cairuijie-cai/RC-volleyball/2027/素材/31x31x19角码参考工程图/尺寸依据与待确认项.md

# 31×31×19角码尺寸参考图

依据用户提供的商品尺寸图与聊天截图整理，不是厂家原始工程图。

商品图标注外包络31×31×19 mm、厚度2 mm、孔径6 mm，以及竖直面8/12/9 mm尺寸链。商家称两孔横向错位约5 mm，没有确认准确的侧边距。

## 图中的假设

- 横向孔中心暂按7 mm、12 mm示意，等于在19 mm宽度中对称偏置±2.5 mm；准确坐标未知。
- 竖直面孔心由上边向下8 mm、再向下12 mm推算，得到从外包络底边向上23 mm、11 mm。
- 9 mm的基准暂理解为底板内表面；8+12+9=29 mm，加厚度2 mm得到31 mm。这不是实物测量。
- 底面孔心沿腿长暂参照竖直面，准确纵向距离及横向错位方向均需实测。
- 外圆角、内折弯半径、孔口是否沉孔/沉头/翻边、材质、表面处理、公差没有资料，因此未补造。
- 侧视折弯处采用直角轮廓示意，不提供展开图或下料尺寸。

PDF/SVG用于尺寸沟通和装配参考。DXF几何按毫米1:1建立，布局为独立参考视图，并以原生DIMENSION实体记录基本尺寸；没有用AutoCAD或SolidWorks原生打开验收，不是SLDDRW/DWG。

核对实物时至少测量两面的每个孔心到同一侧边、自由端边的距离，以及内折弯R和孔口形状。配套零件的匹配孔位应以该实测值为准。
