cairuijie-cai/RC-volleyball/2027/素材/宇树M8010/官方文档/STM32例程_官方原文.md

# GO-M8010-6 关节电机 STM32 HAL 通讯例程

[GoM_ComDemo_STM32_HAL.zip](https://oss-global-cdn.unitree.com/static/7af2438fd70548879b80a0068ef159b3.zip)

基于 STM32F103C8T6 的 GO-M8010-6 关节电机通讯协议 Demo。如果要移植到其他型号的 MCU，推荐使用带有 FPU 的 MCU。

## 硬件要求

1. **MCU UART/USART 外设**需要支持 4Mbps 的波特率。
2. [TTL转RS485模块](https://detail.tmall.com/item.htm?id=679335252560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)（RS485 收发器）需要支持 4Mbps 的波特率（Unitree 旗舰店有售）。

## TTL 转 RS485 模块的连线

| [TTL 转 485 模块] | [MCU]  |
|---|---|
| RX | PA10 |
| TX | PA9 |
| RE/DE | PA11 |
| 5V | 5V |
| GND | GND |



## RS485 线序定义

[RS485 线序定义](https://support.unitree.com/home/zh/Motor_SDK_Dev_Guide/4-channel_485_to_USB_module)

推荐使用 GH1.25-3P 连接器，可以搭配 Unitree 电机附件包使用。为了保证可靠的通讯质量，RS485 总线的 GND 与 MCU 的 GND 必须连接到一起。

## 注意事项

- 请勿将 RS485 的 A 或 B 连通高压，例如 A 与 DC24v 连通。这会造成总线上的所有非隔离的 RS485 设备烧毁，并且这不在保修范围内。

## 调试流程

将``TTL转485模块``引出的``RS485信号线``与电机连接。
将SWD接口与调试器连接，开发板供电。

下载例程程序后，进入Debug模式调试。

添加`Watch 1`窗口

添加 `cmd` 和 `data`变量

点击Run按钮 开始执行程序

此时查看`Watch 1`窗口，展开`data`变量，可以看到数据开始更新，`timeout`应为0，这是正常的。

如果没有与电机成功建立连接，则`timeout`会一直增加

查看`Watch 1`窗口，展开`cmd`变量，将`mode`设置为5，电机会开始缓慢开环转动
此时 T/W/Pos/K_P/K_W 参数不会响应
`mode`设置为0，电机停止转动

将`mode`设置为1，T/W/Pos/K_P/K_W均设置为0，电机进入零力矩模式，用手转动输出端会发现阻力很小，类似于电机没有上电时的状态。

T/W/Pos/K_P/K_W的参数设置请参考：[https://support.unitree.com/home/zh/Motor_SDK_Dev_Guide/overview](https://support.unitree.com/home/zh/Motor_SDK_Dev_Guide/overview)

> 请注意，使用该例程控制电机所有的参数均为转子侧（而不是输出端侧）

STM32的例程与C++版本的例程，参数命名并不相同，请您留意：
| col | [stm32] | [C++] |
| - | - | - |
| 前馈力矩 | T | Tau |
| 期望角度位置 | Pos | Q_des |
| 期望角速度 | W | dq_des |
| 期望刚度  | K_P | Kp |
| 期望阻尼  | K_W | Kd |
