cairuijie-cai/RC-volleyball/2027/素材/宇树M8010/官方文档/关于M8010_官方原文.md

# 关于 GO-M8010-6 电机

<center>



</center>

**GO-M8010-6** 是宇树推出的一款一体化关节电机模组，内部集成了**无刷电机**、**减速器**、**单圈绝对值编码器**与 **FOC 驱动板**。用户可通过高速 RS485 通信下发位置、速度、力矩及力位混合控制指令，适用于四足机器人、机械臂、移动机器人关节、教学科研与竞赛开发等场景。

## 电机参数

| 参数类型 | 参数 | 参数类型 | 参数 |
| :---: | :---: | :---: | :---: |
| 通信方式 | RS485 | 波特率 | 4.0 Mbit/s |
| 数据位 | 8 | 校验位 | None |
| 停止位 | 1 | 串口格式 | 8N1 |
| 工作电压 | 12V ~ 30V DC，推荐 24V DC | 演示例程最低供电能力  | 24V / 5A |
| 最大绝对耐压 | 60V | 过压保护电压 | 45V |
| 最大相电流 | 40A | 建议线缆 |  ≥18AWG，线长 <1m |
| 电机 ID | 0~14 | 单总线电机数量 | 最多 15 个 |
| 控制帧长度 | 17 Byte | 反馈帧长度 | 16 Byte |
| 校验方式 | CRC16_CCITT | 减速比 | 1:6.33 |
| 最大扭矩 | 23.7 N·m | 扭矩常数 | 0.63895 N·m/A |
| 最大转速 | 30 rad/s（24V 供电时） | 电机重量 | 约 530g |
| 电机尺寸 | 96.5 × 92.5 × 42.3 mm | 编码器分辨率 | 15 bit |
| 通信控制频率 | 6000 Hz | 使用环境 | -5℃ ~ 40℃ |
| 电机感知反馈 | 力矩、角度、角速度、温度 | 电机控制指令 | 力矩、角度、角速度、刚度、阻尼 |

## 控制模型

GO-M8010-6 支持力位混合控制，核心关系为：

$$
\tau = \underbrace{\tau_{ff}}_{\text{前馈力矩}} + \underbrace{k_p(q_{des}-q)}_{\text{位置误差力矩}} + \underbrace{k_d(\dot{q}_{des}-\dot{q})}_{\text{速度误差力矩}}
$$

> **注意**
> 
> - SDK 和协议中的控制量默认按**电机转子侧**理解，不是输出端侧。
> - 输出端位置、速度换算到转子侧时，需要乘以 GO-M8010-6 的减速比 **6.33**。

## 电机参数曲线

<center>



</center>

说明：上图为 GO-M8010-6 的 TN 曲线，数据为**转子侧**在 **24V 供电**下测得，用于查看不同转速下的扭矩能力。

## 供电说明

> **警告：制动 / 正反转快速切换工况下存在母线过压风险**

> **注意**
> 
> - 满足演示例程至少需要 **24V、5A** 的供电能力。
> - 线缆建议至少 **18AWG**，线长 **< 1m**。
> - 实际供电能力需按负载、加速度和同时动作电机数量留裕量。

### 制动工况下的母线过压风险

电机在正反转快速切换、位置阶跃响应或急减速制动过程中，转子动能会转化为电能回馈至直流母线。若供电电源为普通开关电源，且不具备能量吸收能力，该电能无法被吸收，可能导致母线电压升高。

GO-M8010-6 电机具备过压保护，电机本体通常会进入保护状态，但外部电源仍可能因母线电压升高而损坏。调试高动态工况时，应特别关注电源是否具备吸收回灌能量的能力。

### 措施建议

- 调试时避免发送**大幅度**位置阶跃或高频正反转指令，优先使用**平缓**轨迹规划。
- 优先使用**锂电池**或具备能量回馈能力的**双向电源**。
- 如使用普通开关电源，应确认电源耐压、保护方式和是否允许反灌。

## 电机尺寸

<center>



</center>

3D 模型：[GO-M8010-6 电机 3D 模型 STP](https://unitree-firmware.oss-cn-hangzhou.aliyuncs.com/tool/GO-M8010-6%E7%94%B5%E6%9C%BA3D%E6%A8%A1%E5%9E%8B.stp)

## 接口说明

<center>



说明：GO-M8010-6 使用的 **XT30PB-M(2+2)** 连接器引脚定义。

</center>

GO-M8010-6 通过电源线和 RS485 通信线连接。典型信号包括：

- **A**：RS485 的 `A` 相
- **B**：RS485 的 `B` 相
- **GND**：RS485 通信地，需要与控制器或 USB 转 485 模块共地；USB 转 485 模块的 GND 需要与电机电源负极连通（附件包中已经完成该接地连通操作）
- **+**：电源输入正极
- **-**：电源输入负极

> **警告**
> 
> RS485 的 A/B 信号线不可接入 24V 或其他高压。改线、增减电机、插拔 XT30 或通信线前建议先断电。热插拔可能导致 RS485 总线的 **10R 限流电阻烧毁**。

## 模式与指示灯

可通过电机背部绿色指示灯判断当前模式。

模式切换：Windows 使用[电机调试助手](Motor_debugging_assistant.md)，Linux 使用 [MotorTools](https://github.com/unitreerobotics/unitree_actuator_sdk/tree/main/motor_tools)。

| 对比项 | 电机模式 | 工厂模式 / Bootloader |
| --- | --- | --- |
| 指示灯 | 慢闪 / 每秒闪烁 1 次 | 快速 3 连闪 |
| 用途 | 默认工作模式，用于接收运动控制指令 | 配置模式，用于查询 ID、修改 ID、固件升级等 |
| 是否可控制运动 | 可以 | 不用于普通运动控制 |
| 是否可修改配置 | 不可修改内部配置 | 可以进行配置相关操作 |
| 切换命令 | `sudo ./swmotor /dev/ttyUSB0` | `sudo ./swboot /dev/ttyUSB0` |

| 模式演示 | 电机模式 | 工厂模式 / Bootloader |
| --- | --- | --- |
| 指示灯 GIF |  |  |

## 开发入口

> **警告**
> 
> 若首次开发宇树系列电机，请至少阅读应用开发章节：[点击跳转应用开发](https://support.unitree.com/home/zh/Motor_SDK_Dev_Guide/overview)

## 在线购买

**前往淘宝购买 GO-M8010-6 电机**：[点击购买 GO-M8010-6](https://detail.tmall.com/item.htm?id=679335252560)
