cairuijie-cai/RC-volleyball/2027/素材/宇树M8010/官方文档/资料下载_官方原文.md

# 汇总下载

本页汇总 GO-M8010-6 开发中常用的软件、例程、模型和驱动下载入口。

---

## 产品手册

| 名称 | 语言 | 下载 |
| --- | --- | --- |
| GO-M8010-6 电机使用手册_20240515.pdf | 中文 | [下载 PDF](https://oss-global-cdn.unitree.com/static/ba47968cb8b54cc0a602d672e51d15c3.pdf) |
| GO-M8010-6 Motor User Manual_20240515.pdf | English | [Download PDF](https://oss-global-cdn.unitree.com/static/33c284af73014b2184b18dffe0b5be4c.pdf) |

---

## 开发 SDK

| 名称 | 用途 | 下载 |
| --- | --- | --- |
| unitree_actuator_sdk | C++ / Python 电机控制 SDK | [GitHub - unitree_actuator_sdk](https://github.com/unitreerobotics/unitree_actuator_sdk/tree/main) |

---

## 调试工具

| 名称 | 用途 | 下载 |
| --- | --- | --- |
| Unitree MotorTools | Linux 命令行工具，包含 `swboot`、`swmotor`、`changeid`、`unisp` 等 | [unitree_actuator_sdk/motor_tools](https://github.com/unitreerobotics/unitree_actuator_sdk/tree/main/motor_tools) |

---

## 示例工程

| 名称 | 用途 | 下载 |
| --- | --- | --- |
| GO-M8010-6 STM32 HAL 通讯例程 | STM32F103C8T6 对接 GO-M8010-6 的 HAL Demo | [GoM_ComDemo_STM32_HAL.zip](https://oss-global-cdn.unitree.com/static/7af2438fd70548879b80a0068ef159b3.zip) |
| 4 路 USB 转 485 多电机例程 | 使用 4 路 USB 转 485 模块控制多个 GO-M8010-6 | [block_comm_test 示例工程](https://oss-global-cdn.unitree.com/static/982515d647c04ffd99ed48d67311517e.zip) |

## 模型文件

| 名称 | 用途 | 下载 |
| --- | --- | --- |
| GO-M8010-6 电机简化模型 | 结构设计、装配验证 | [GO-M8010-6 电机 3D 模型 STP](https://unitree-firmware.oss-cn-hangzhou.aliyuncs.com/tool/GO-M8010-6%E7%94%B5%E6%9C%BA3D%E6%A8%A1%E5%9E%8B.stp) |
| A1 电机简化模型 | 结构设计、装配验证 | [A1_motor.STEP](https://unitree-firmware.oss-cn-hangzhou.aliyuncs.com/tool/A1_motor.STEP) |

---

## 电机固件

| 名称 | 版本 | 发布时间 | 更新说明 | 下载 |
| --- | --- | --- | --- | --- |
| E_GO-M8010-6_DRV_v1.4.5_HW2.bin | v1.4.5 | 2025-10-30 | 修复了总线通信频率过高会导致电流环降频的问题 | [下载 ZIP](https://oss-global-cdn.unitree.com/static/af10a41124704a27ae333c1a5a2b575c.zip) |

> 固件下载后需要解压，搭配 MotorTools 或 Unitree 电机调试助手使用。

---

## 驱动与外部工具

| 名称 | 用途 | 链接 |
| --- | --- | --- |
| FTDI 系列芯片 USB 转 485 模块驱动 | 适用于 FT232H / FT4232H 等 USB 转 485 模块 | [下载驱动 ZIP](https://oss-global-cdn.unitree.com/static/29919b2689364f27b0fbd874d52ac487.zip) |
| Ubuntu PREEMPT_RT 实时内核补丁参考 | 多电机高实时性通信场景参考 | [Ubuntu22.04 编译实时内核安装 PREEMPT_RT 实时补丁](https://blog.csdn.net/wq20202/article/details/130718111) |

---

## 硬件购买入口

| 名称 | 用途 | 链接 |
| --- | --- | --- |
| GO-M8010-6 电机 | GO-M8010-6 电机本体购买入口 | [购买入口](https://detail.tmall.com/item.htm?id=679335252560) |
| 单路 USB 转 485 通信模块 | 单路 RS485 调试、少量电机通信 | [购买入口](https://detail.tmall.com/item.htm?id=679335252560&skuId=5045470746826) |
| 4 路 USB 转 485 通信模块 | 多路 RS485、多电机通信 | [购买入口](https://detail.tmall.com/item.htm?id=679335252560&skuId=5795061774735) |
| CAN 转 485 通信模块 | CAN 控制器接入 Unitree 电机 | [购买入口](https://detail.tmall.com/item.htm?id=679335252560&skuId=5485853851287) |
| TTL 转 RS485 模块 | STM32 等 MCU 接入 GO-M8010-6 | [购买入口](https://detail.tmall.com/item.htm?id=679335252560&skuId=4943221225710) |

---

## 硬件开发资料

| 名称 | 用途 | 下载 |
| --- | --- | --- |
| 硬件开发资料_集成库文件 | Altium Designer 封装库，含 XT30 PB(2+2)、XT30 PW(2+2)、GH1.25 3Pin、TTL 转 485 模块 | [下载 ZIP](https://oss-global-cdn.unitree.com/static/2360943378c640709c419cbfe39a8223.zip) |
