cairuijie-cai/RC-volleyball/2026/排球素材/README.md

# 2026排球现场资料与视频下载

[打开夸克网盘分享「排球」](https://pan.quark.cn/s/b4b73413abca)

分享页在2026-11-03核对时显示永久有效，无需提取码即可查看文件列表。分享包含现场视频和照片，按学校分目录。

已核对以下13个视频的文件名与字节大小，均与原始资料一致；此次未逐段播放验证。仓库当前版本保留现场照片，视频通过上述网盘下载。

| 学校／队伍 | 视频文件名 | 大小/MiB |
|---|---|---:|
| 大连交通大学 | `VID_20260716_103423.mp4` | 87.3 |
| 大连交通大学 | `VID_20260716_103503.mp4` | 33.9 |
| 大连交通大学 | `VID_20260716_103545.mp4` | 91.0 |
| 宁夏工程学院 | `VID_20260716_104953.mp4` | 58.1 |
| 宁夏工程学院 | `VID_20260716_105040.mp4` | 69.9 |
| 宁夏工程学院 | `VID_20260716_105251.mp4` | 47.7 |
| 沈阳工业大学2队 | `VID_20260716_113043(1).mp4` | 95.6 |
| 沈阳工业大学2队 | `VID_20260716_113043.mp4` | 95.6 |
| 沈阳工业大学2队 | `VID_20260716_114644.mp4` | 49.0 |
| 沈阳工业大学2队 | `VID_20260716_114727.mp4` | 71.1 |
| 河北工程大学 | `VID_20260716_103902.mp4` | 42.3 |
| 河北工程大学 | `VID_20260716_103913.mp4` | 38.8 |
| 河北工程大学 | `VID_20260716_103932.mp4` | 28.0 |

## 不在该分享中的开源演示视频

下列4个视频随福州大学开源模型保存，未包含在本次分享中，保留仓库原文件，可使用Git LFS完整下载。

- `2027/素材/RM论坛排球开源/RC2026-福州大学-浮舟湿地-R2排球机器人机械结构开源/RC2026-福州大学-浮舟湿地-R2排球机器人机械结构开源/效果展示/接球.mp4`
- `2027/素材/RM论坛排球开源/福州大学-浮舟湿地战队排球机器人R1机械开源/福州大学-浮舟湿地战队排球机器人R1机械开源/功能展示/完整演示.mp4`
- `2027/素材/RM论坛排球开源/福州大学-浮舟湿地战队排球机器人R1机械开源/福州大学-浮舟湿地战队排球机器人R1机械开源/功能展示/慢动作.mp4`
- `2027/素材/RM论坛排球开源/福州大学-浮舟湿地战队排球机器人R1机械开源/福州大学-浮舟湿地战队排球机器人R1机械开源/功能展示/赛场表现.mp4`

下载仓库中的模型及演示视频，请参照[仓库下载说明](../../README.md#下载模型与其他资料)。
