cairuijie-cai/RC-volleyball/2027/素材/RM论坛排球开源/福州大学-浮舟湿地战队排球机器人R1机械开源/福州大学-浮舟湿地战队排球机器人R1机械开源/readme.txt

该开源文档主要包含以下三部分:
1.技术说明文档包含需求分析、功能设计、机械设计方案、版本迭代过程
2.功能展示包含发球的效果演示
3.3D图纸包含整车机械3D图纸,格式为step
开源说明:
1.本开源仅限于参赛队之间队内交流使用,不允许任何商业用途。
2.开源目的为加强参赛队之间交流,有助于提高自身和其他参赛队的水平。
3.本开源的最终解释权为福州大学浮舟湿地战队所有。
