cairuijie-cai/RC-volleyball/2027/素材/M3508官方工程图/官方来源与尺寸说明.md

# RoboMaster M3508 P19 官方外形与安装尺寸图

下载与核对日期：2026-10-13。

来源：DJI/RoboMaster 官方使用说明，V1.0，2017.08。
官方PDF：https://rm-static.djicdn.com/robomasters/public/document/RoboMaster%20M3508%20P19%20Brushless%20DC%20Gear%20Motor%20V1.0.pdf
产品页面：https://www.robomaster.com/zh-CN/products/components/general/M3508

本目录的 PDF 是官方原文件，没有修改。
中文安装图位于PDF第10页；英文对应第4页，日文对应第16页。
PNG为官方PDF页面渲染。外形与安装尺寸.png只渲染安装图区域，未重绘或补造尺寸。

已核对的关键标注（单位mm）：
- 最大外径：Ø42
- 总长：98.40 ±1
- 图中本体长度：66.70 ±1
- 输出轴直径：Ø10，上偏差-0.05，下偏差-0.10
- 轴端螺纹：M5-6H，深度10
- 安装孔：4×M4×0.7，深度10
- 安装孔分布圆：Ø35
- 前端定位凸台：Ø26，上偏差0，下偏差-0.10

安装螺钉的实际旋入深度应结合安装板厚度核对。官方说明提醒，过长螺钉可能顶到减速箱外齿圈并损坏电机。
这些尺寸对应官方原装M3508 P19；自制或更换的减速箱、输出轴需按具体模型与实物核对。

本次没有生成SLDDRW或DWG，也没有把安装参考图描述为电机内部零件的制造图。
