cairuijie-cai/RC-volleyball/2026/排球素材/V04/mmexport1784181933411.jpg

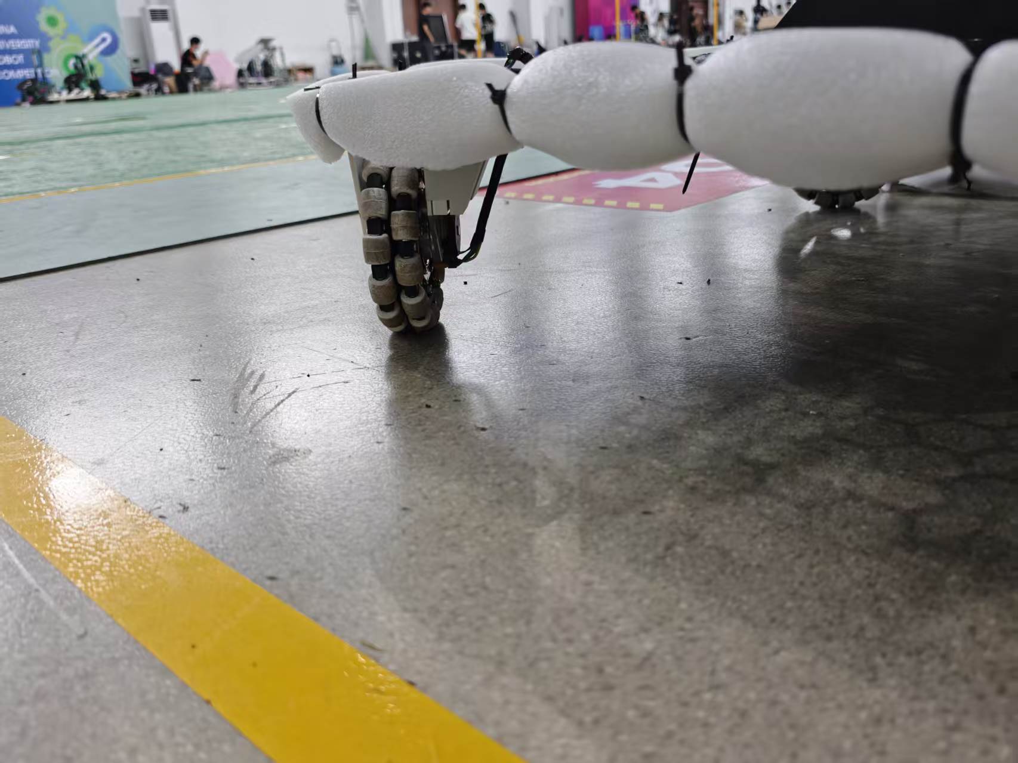
2026/排球素材/V04/mmexport1784181933411.jpg
