cairuijie-cai/RC-volleyball/2026/排球素材/V04/mmexport1784181936968.jpg

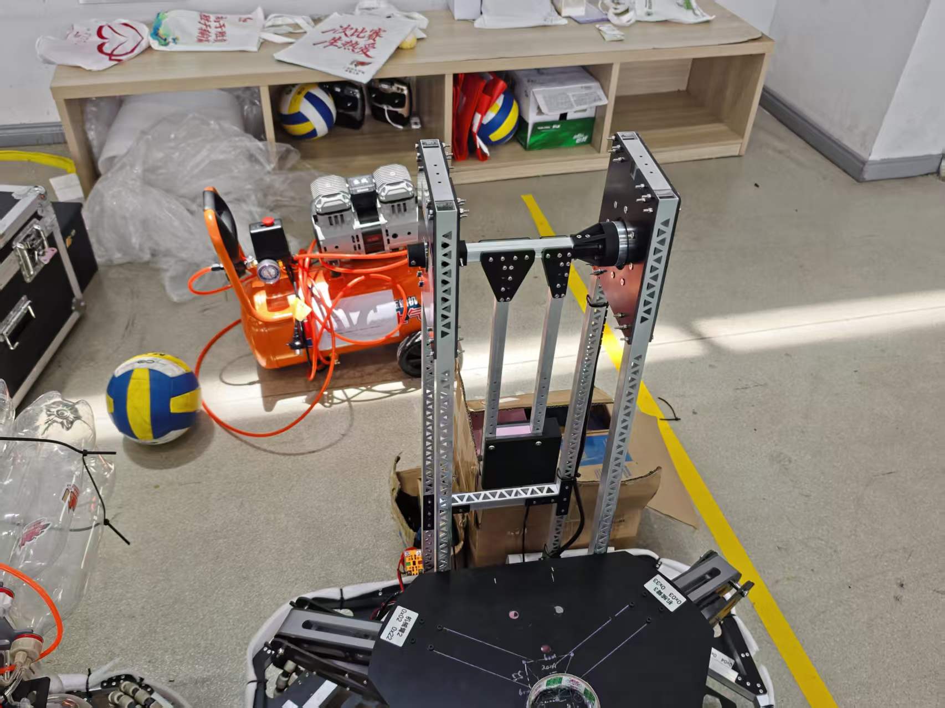
2026/排球素材/V04/mmexport1784181936968.jpg
