cairuijie-cai/RC-volleyball/2026/排球素材/大连交通大学/IMG_20260716_103158.jpg

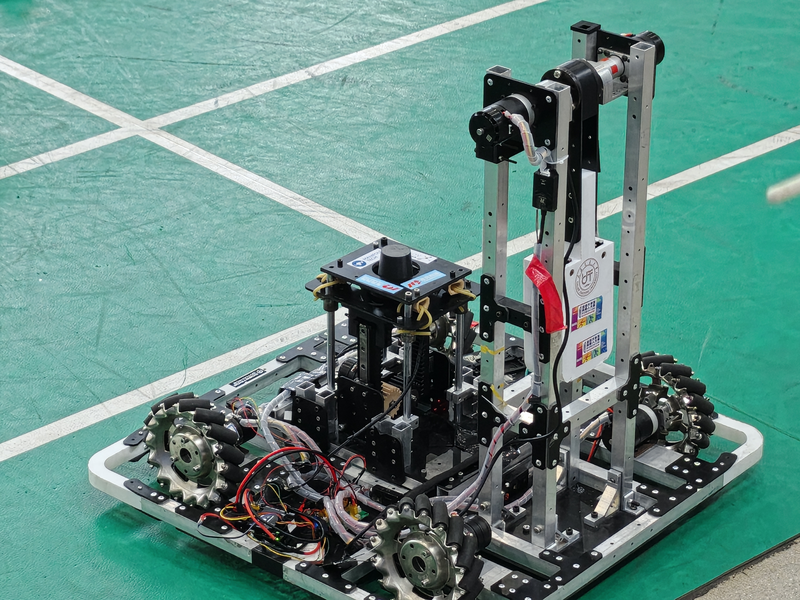
2026/排球素材/大连交通大学/IMG_20260716_103158.jpg
