cairuijie-cai/RC-volleyball/2026/排球素材/宁夏工程学院/IMG_20260716_104541.jpg

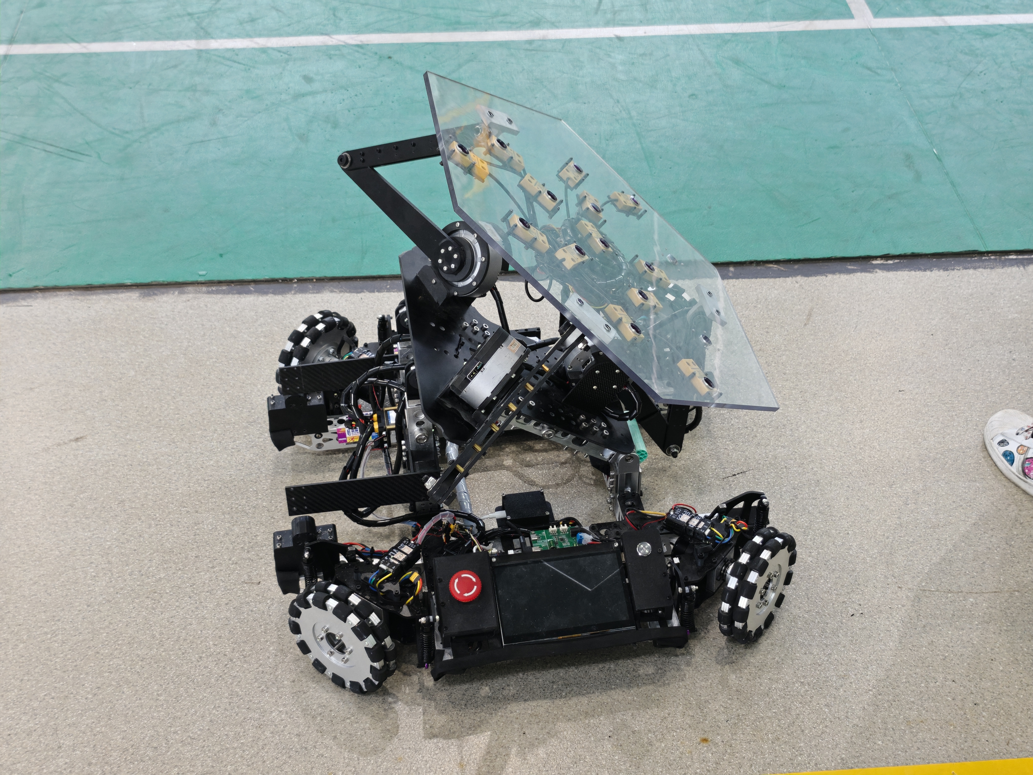
2026/排球素材/宁夏工程学院/IMG_20260716_104541.jpg
