cairuijie-cai/RC-volleyball/2026/排球素材/沈阳工业大学2队/IMG_20260716_114238.jpg

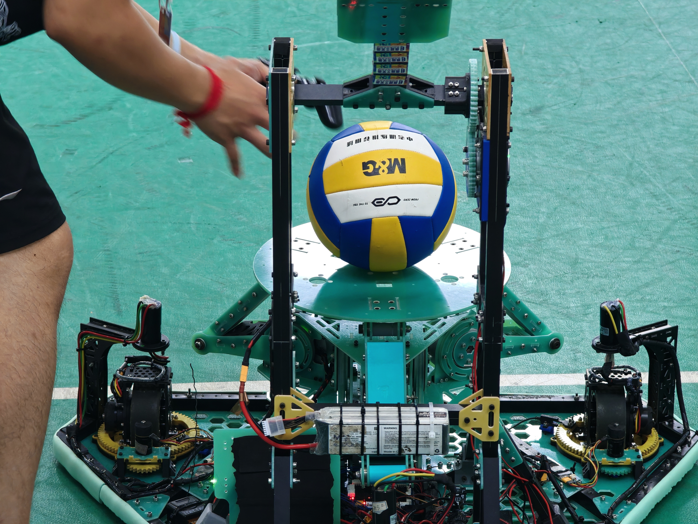
2026/排球素材/沈阳工业大学2队/IMG_20260716_114238.jpg
