cairuijie-cai/RC-volleyball/2026/排球素材/河北工程大学/IMG_20260716_103946.jpg

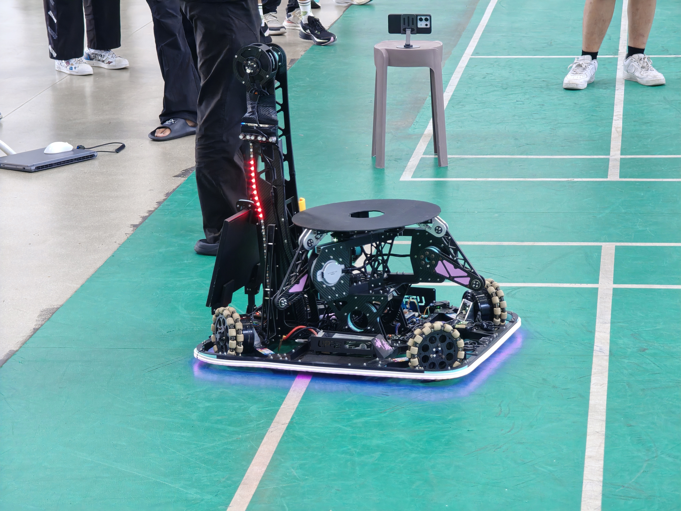
2026/排球素材/河北工程大学/IMG_20260716_103946.jpg
