cairuijie-cai/RC-volleyball/2026/泡泡轮/OpenTpuOmniWheel-main/OTOW-Pic1.jpg

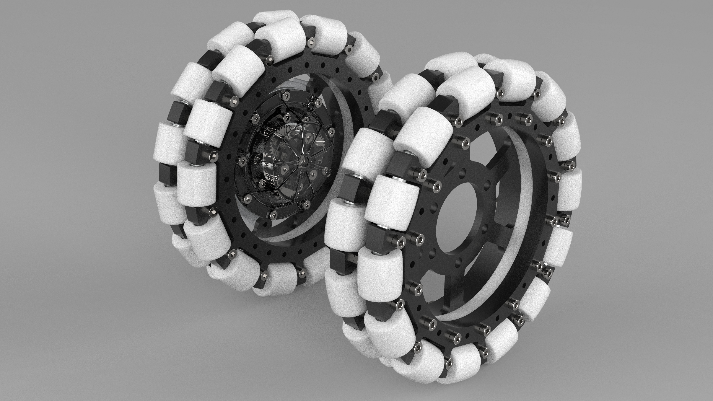
2026/泡泡轮/OpenTpuOmniWheel-main/OTOW-Pic1.jpg
