cairuijie-cai/RC-volleyball/2027/素材/31x31x19角码参考工程图/DXF预览.png

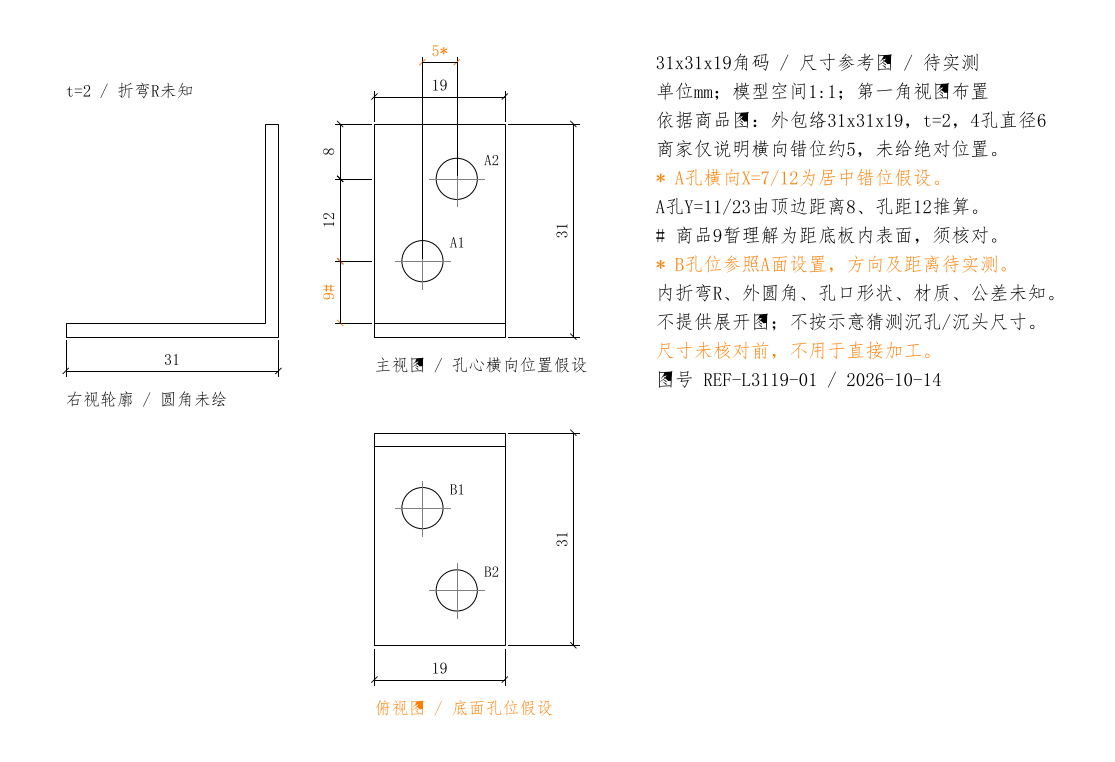
2027/素材/31x31x19角码参考工程图/DXF预览.png
