cairuijie-cai/RC-volleyball/2027/素材/M3508官方工程图/M3508_P19_外形与安装尺寸.png

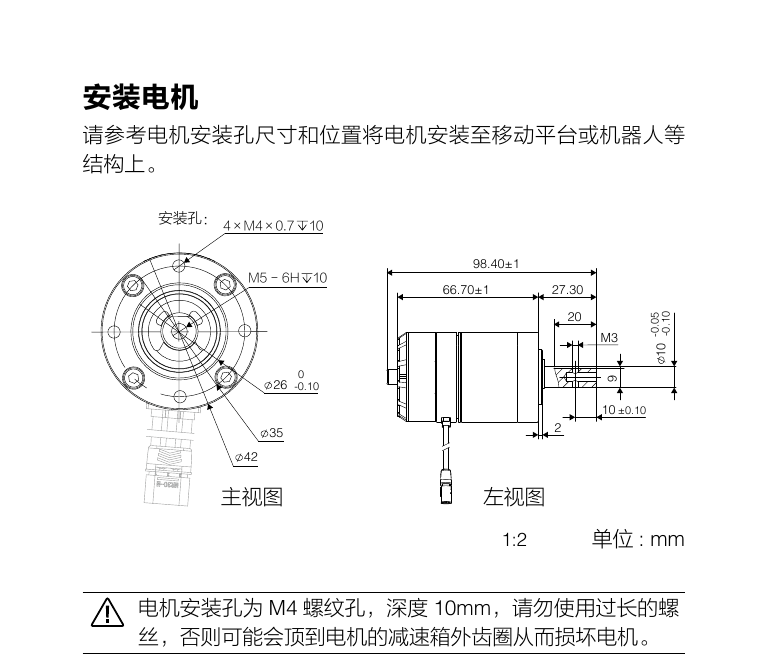
2027/素材/M3508官方工程图/M3508_P19_外形与安装尺寸.png
