cairuijie-cai/RC-volleyball/2027/素材/M3508官方工程图/M3508_P19_官方安装尺寸图_第10页.png

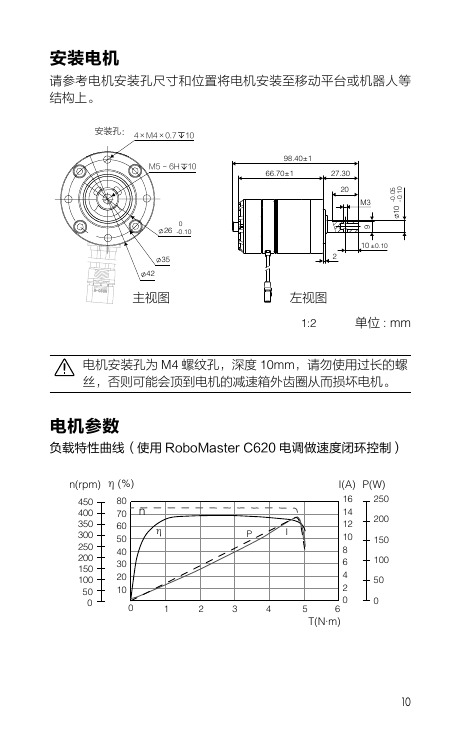
2027/素材/M3508官方工程图/M3508_P19_官方安装尺寸图_第10页.png
