cairuijie-cai/RC-volleyball/2027/素材/宇树M8010/GO-M8010-6官方尺寸图.jpg

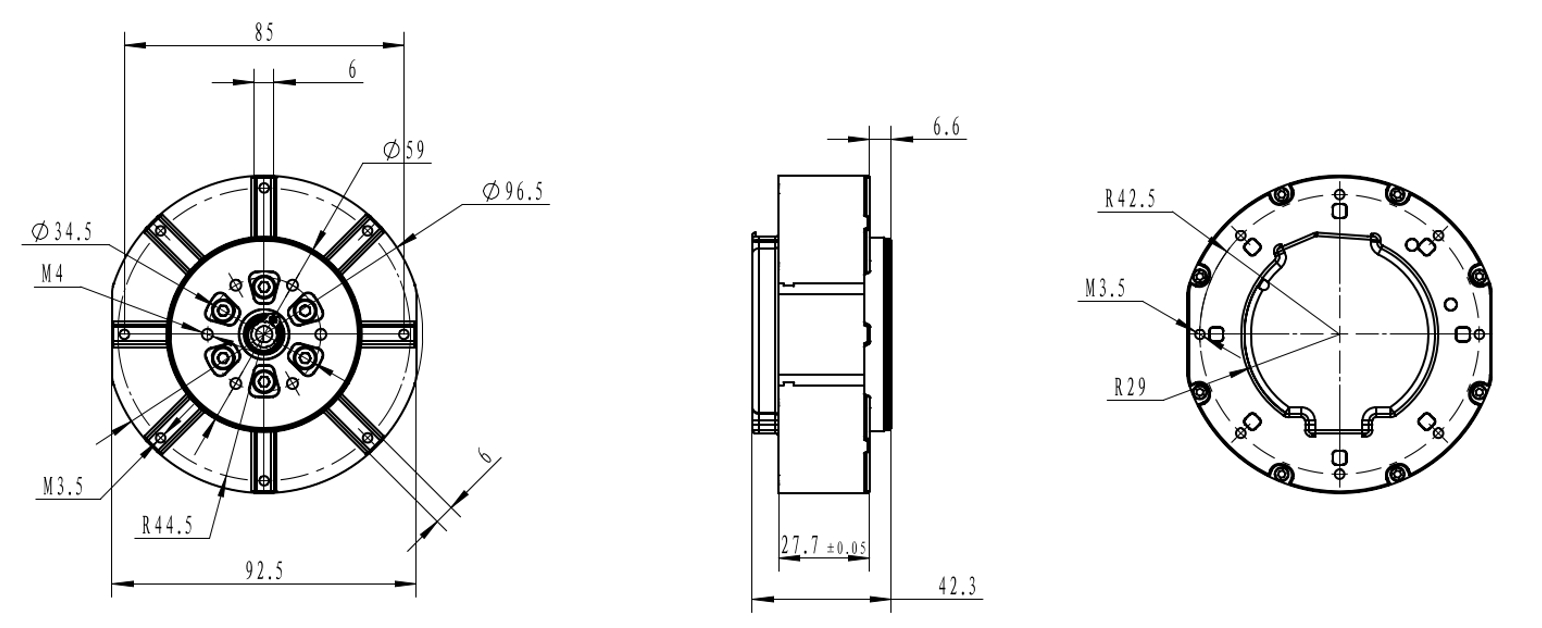
2027/素材/宇树M8010/GO-M8010-6官方尺寸图.jpg
