cairuijie-cai/RC-volleyball/2026/泡泡轮/OpenTpuOmniWheel-main/OTOW-SW2021/OTOW-滚子装配.SLDASM

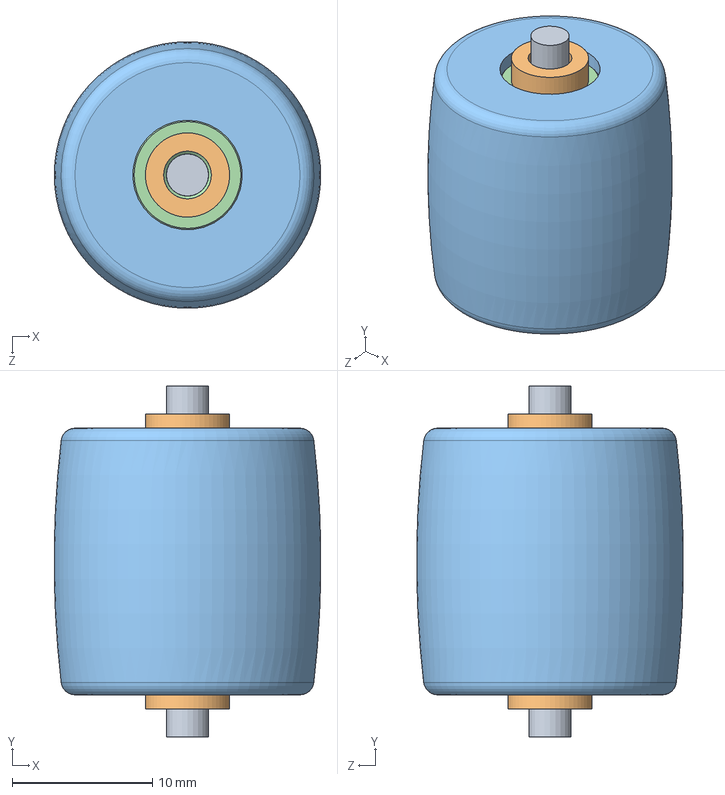
[picture p60: CAD file, 2026-11-02]
2026/泡泡轮/OpenTpuOmniWheel-main/OTOW-SW2021/OTOW-滚子装配.SLDASM
19.0 x 25.0 x 19.0 mm
OTOW-销钉3x25
OTOW-垫片3.4x6x2 x 2
OTOW-注塑滚子
OTOW-轴承3x8x4 x 2
