cairuijie-cai/RC-volleyball/2026/R5/底盘/sw文件/底盘.SLDASM

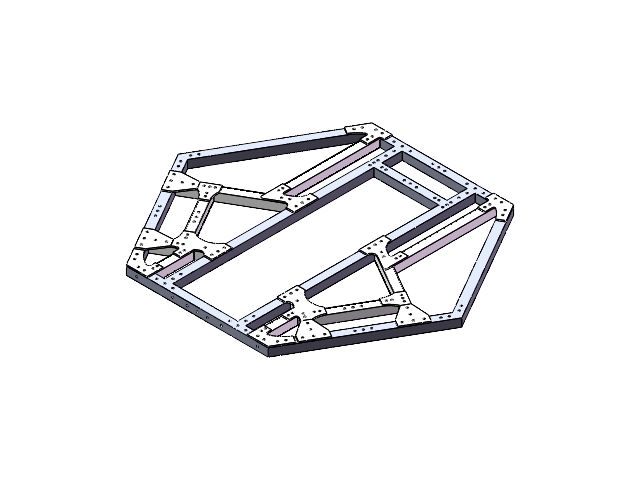
[picture p61: CAD file, 2026-11-02]
2026/R5/底盘/sw文件/底盘.SLDASM
泡泡-底盘
上 x 2
中 x 2
中下1 x 2
中下2 x 2
下 x 2
上2 x 2
下上1 x 2
中上 x 2
下上2 x 2
下2 x 2
中下下1 x 2
中下下2 x 2
