cairuijie-cai/RC-volleyball/2027/发球机器人/发球机器人/RC发球机器人.SLDASM

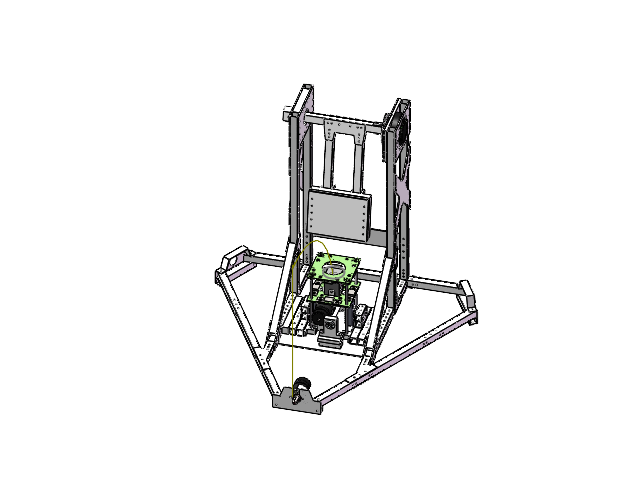
[picture p62: CAD file, 2026-11-02]
2027/发球机器人/发球机器人/RC发球机器人.SLDASM
60方钢 x 3
13方钢 x 3
盖板 x 2
电机前板 x 3
横架 x 2
3508电机.
电机缓冲件
横梁前连接 雕刻件 x 4
横梁后 下 连接 雕刻件 x 2
拍架20x20x740，后 x 2
关节电机连接板 外 雕刻件
GO-M8010-6
关节电机填充 打印件
关节电机连接板 内 雕刻件
拍架20x20x740，前 x 2
拍架长连接 雕刻件
拍架宽连接 雕刻件 x 2
转轴关节电机L型角码 连接 雕刻件
转轴关节电机L型角码连接 增厚 雕刻件
转轴关节电机L型角码连接 增厚 打印件
L形角码 x 2
轴承固定填充 打印件
轴承链接 内 雕刻件
内35，外62，厚14深沟球轴承
轴承外填充 打印件
转轴
轴承链接 外 雕刻件
转轴摆臂连接雕刻件 x 2
摆臂 x 2
拍子反 打印件
拍子正 打印件
配重块
拍板覆盖 雕刻件
发球架底盘L形连接 雕刻件 x 2
固定板（雕刻
GB／T17395-2008普通钢管6×0.3x180 x 4
运动板（雕刻
光轴紧固件（雕刻 x 8
角码20x20x16 x 4
方形卡扣（采购 x 8
顶球桩（打印
顶球桩底板
铝t型夹（采购 x 4
导轨 x 2
3508电机1
直齿条M2长92 x 2
滑块 x 4
3508电机座
轴承支座垫片
轴承支座
齿轮轴
GB／T276-94深沟球轴承6000
外直齿轮M2Z17(打印件 x 2
方管145 x 4
方管50（外发 x 4
电机座垫片
夹爪垫片 x 2
方管50（垫电机 x 2
方管58
斜支撑发球架连接 下 雕刻件 x 4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
