cairuijie-cai/RC-volleyball/2027/发球机器人/发球机器人/底盘/底盘.SLDASM

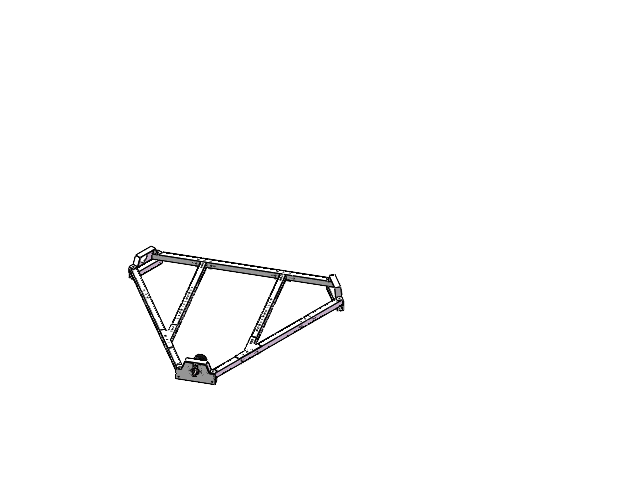
[picture p63: CAD file, 2026-11-02]
2027/发球机器人/发球机器人/底盘/底盘.SLDASM
60方钢 x 3
13方钢 x 3
盖板 x 3
电机前板 x 3
横架 x 2
3508电机.
电机缓冲件 x 2
横梁前连接 雕刻件 x 4
横梁后 下 连接 雕刻件 x 2
