cairuijie-cai/RC-volleyball/2027/发球机器人/发球机器人/排球顶球机构/顶球机构总.SLDASM

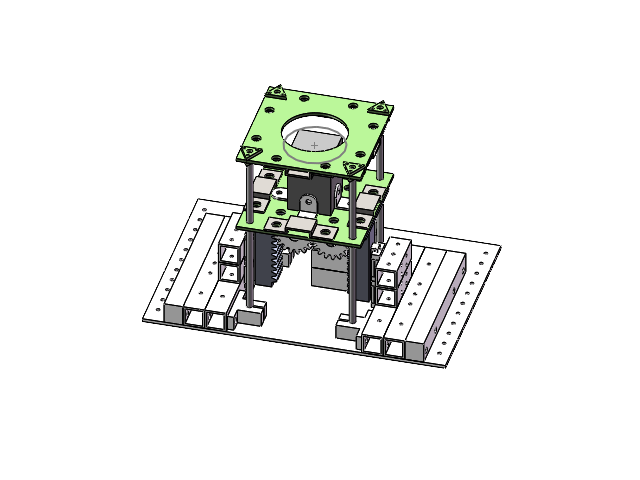
[picture p64: CAD file, 2026-11-02]
2027/发球机器人/发球机器人/排球顶球机构/顶球机构总.SLDASM
固定板（雕刻
GB／T17395-2008普通钢管6×0.3x180 x 4
运动板（雕刻
光轴紧固件（雕刻 x 8
角码20x20x16 x 4
方形卡扣（采购 x 8
顶球桩（打印
顶球桩底板
铝t型夹（采购 x 4
导轨 x 2
3508电机1
直齿条M2长92 x 2
滑块 x 4
3508电机座
轴承支座垫片
轴承支座
齿轮轴
GB／T276-94深沟球轴承6000
外直齿轮M2Z17(打印件 x 2
方管145 x 4
方管50（外发 x 4
电机座垫片
夹爪垫片 x 2
方管50（垫电机 x 2
方管58
