cairuijie-cai/RC-volleyball/2026/R5/气缸车（排球 2）(1)/急停.SLDASM

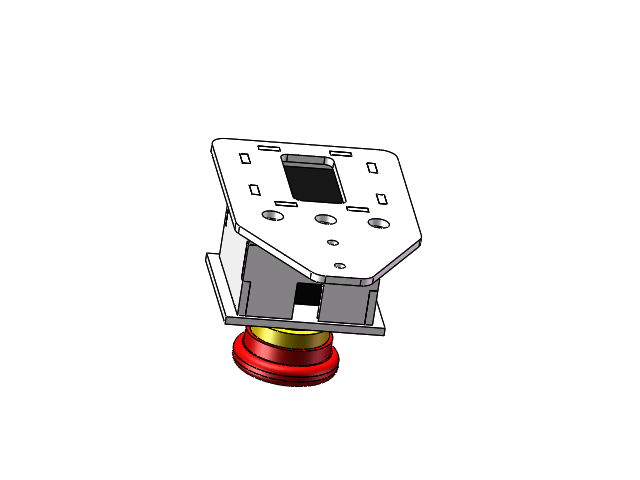
[picture p65: CAD file, 2026-11-02]
2026/R5/气缸车（排球 2）(1)/急停.SLDASM
急停安装板2
急停安装板1 x 2
急停安装板3 x 2
急停开关
急停安装板4
