cairuijie-cai/RC-volleyball/2026/R4/气缸架/装配体1.SLDASM

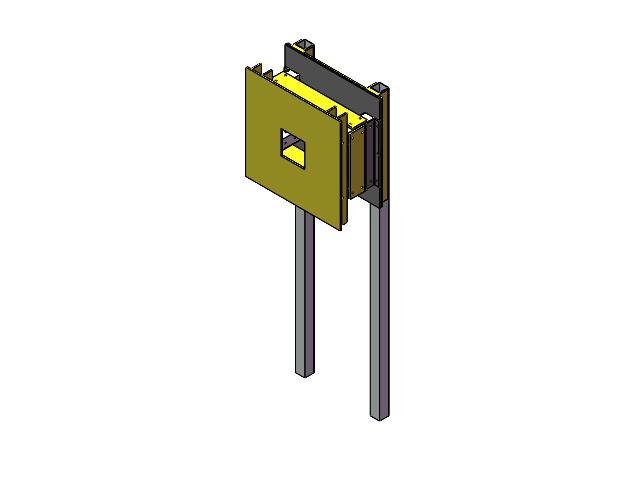
[picture p66: CAD file, 2026-11-02]
2026/R4/气缸架/装配体1.SLDASM
底部铝管 x 2
气缸架
受力碳板
连接 x 2
20x20x80铝管 x 4
60宽连接 x 2
60长连接 x 2
气缸架2层
