cairuijie-cai/RC-volleyball/2026/泡泡轮/OpenTpuOmniWheel-main/OTOW-SW2021/OTOW-全向轮装配.SLDASM

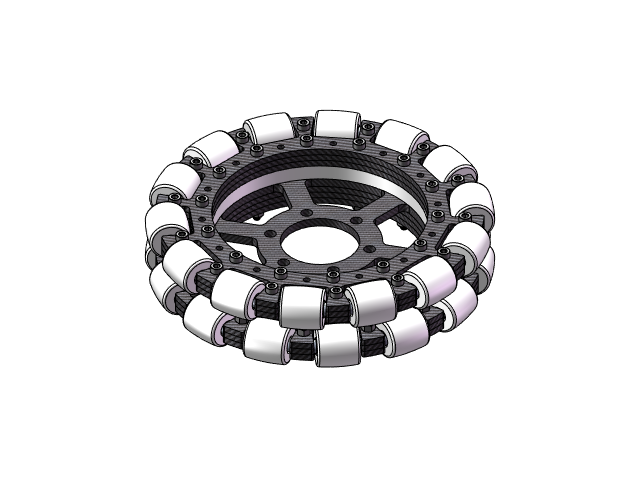
[picture p67: CAD file, 2026-11-02]
2026/泡泡轮/OpenTpuOmniWheel-main/OTOW-SW2021/OTOW-全向轮装配.SLDASM
OTOW-全向轮中板 x 2
OTOW-销钉3x25 x 28
OTOW-垫片3.4x6x2 x 56
OTOW-注塑滚子 x 28
OTOW-轴承3x8x4 x 56
OTOW-全向轮外板 x 4
OTOW-全向轮中间垫块
OTOW-全向轮连轴板-上交联轴器
OTOW-螺丝杯头M3x13 x 28
OTOW-螺母防松M3 x 42
OTOW-螺丝杯头M3x35 x 14
