cairuijie-cai/RC-volleyball/2026/R4/转轴/装配体1.SLDASM

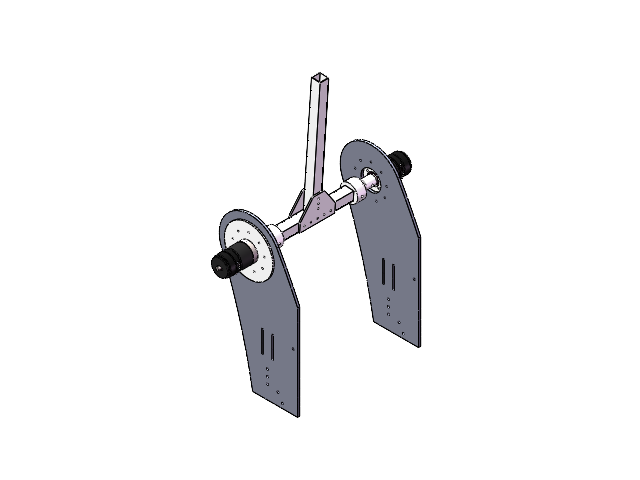
[picture p68: CAD file, 2026-11-02]
2026/R4/转轴/装配体1.SLDASM
玻纤 x 2
3508电机. x 2
电机外固定 x 2
电机固定 x 2
轴
杆连接 x 2
拍杆
