cairuijie-cai/RC-volleyball/2026/R5/气缸车（排球 2）(1)/气缸头连接。.SLDASM

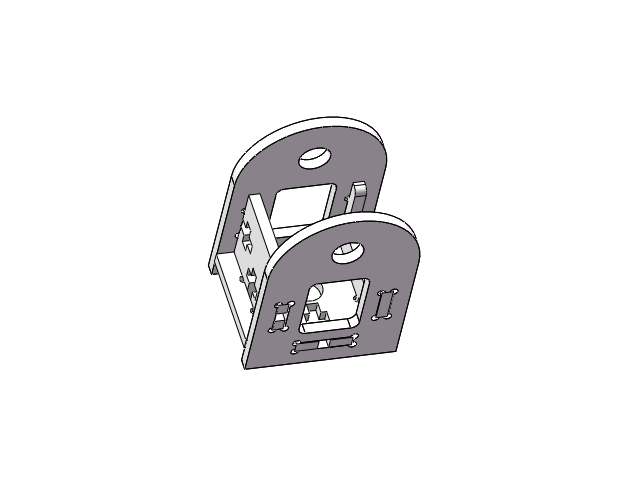
[picture p69: CAD file, 2026-11-02]
2026/R5/气缸车（排球 2）(1)/气缸头连接。.SLDASM
气缸头连接1 x 2
气缸头连接2
气缸头连接3
气缸头连接4
