cairuijie-cai/RC-volleyball/2026/R5/气缸车（排球 2）(1)/MA迷你气缸系列[MA25×250].sldasm

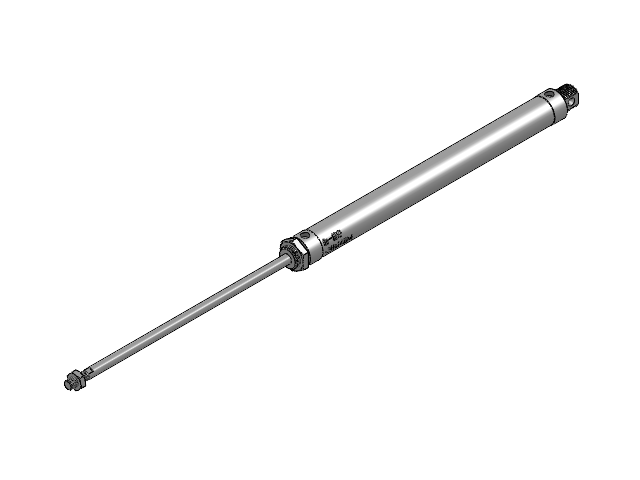
[picture p70: CAD file, 2026-11-02]
2026/R5/气缸车（排球 2）(1)/MA迷你气缸系列[MA25×250].sldasm
MA迷你气缸系列[MA25×250]_机体
MA迷你气缸系列[MA25×250]_活塞
