cairuijie-cai/RC-volleyball/2027/发球机器人/发球机器人/发球机构/发球架.SLDASM

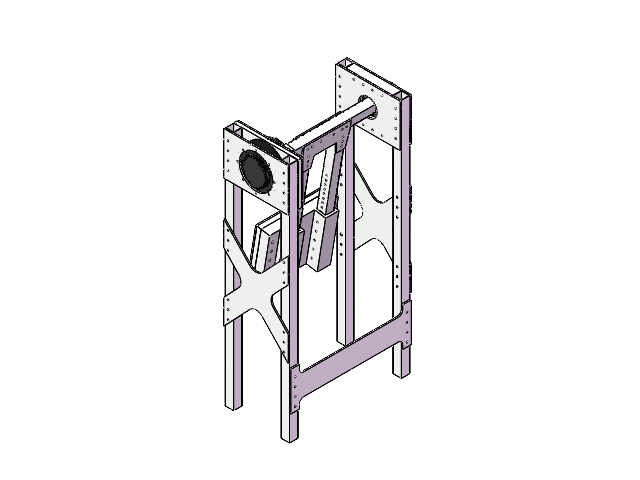
[picture p71: CAD file, 2026-11-02]
2027/发球机器人/发球机器人/发球机构/发球架.SLDASM
拍架20x20x740，后 x 2
关节电机连接板 外 雕刻件
GO-M8010-6
关节电机填充 打印件
关节电机连接板 内 雕刻件
拍架20x20x740，前 x 2
拍架长连接 雕刻件
拍架宽连接 雕刻件 x 2
转轴关节电机L型角码 连接 雕刻件
转轴关节电机L型角码连接 增厚 雕刻件
转轴关节电机L型角码连接 增厚 打印件
L形角码 x 2
轴承固定填充 打印件
轴承链接 内 雕刻件
内35，外62，厚14深沟球轴承
轴承外填充 打印件
转轴
轴承链接 外 雕刻件
转轴摆臂连接雕刻件 x 2
摆臂 x 2
拍子反 打印件
拍子正 打印件
配重块
拍板覆盖 雕刻件
