cairuijie-cai/RC-volleyball/2026/R5/气缸车（排球 2）(1)/电池盒.SLDASM

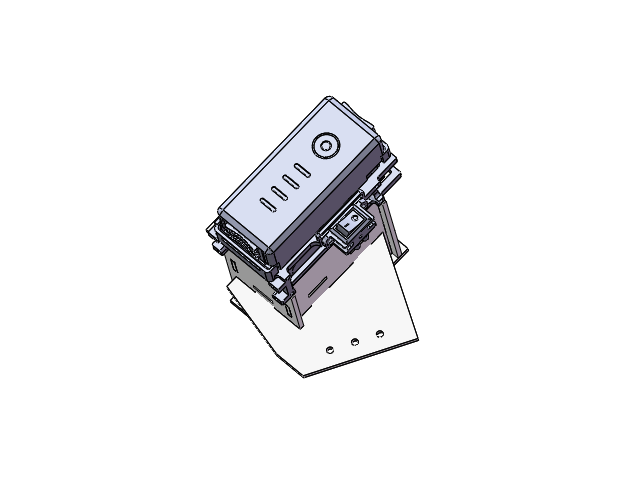
[picture p72: CAD file, 2026-11-02]
2026/R5/气缸车（排球 2）(1)/电池盒.SLDASM
电池1 x 2
电池2 x 2
电池3
电池4
电池5
大疆电池座-2017版(1).step
TB47D00_1_1.step
