cairuijie-cai/RC-volleyball/2027/发球机器人/发球机器人/排球顶球机构/顶球桩总装.SLDASM

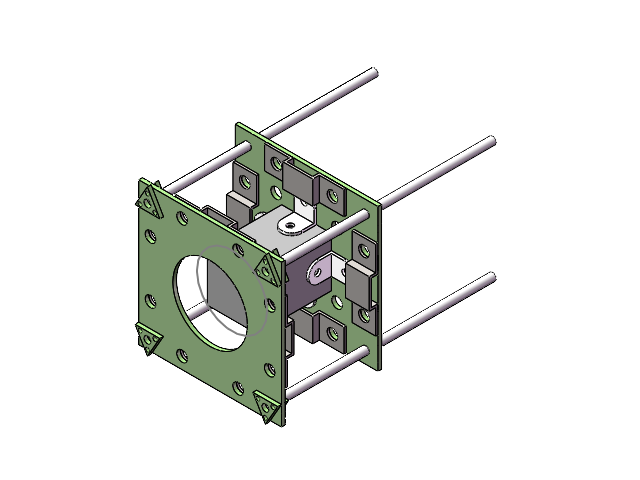
[picture p73: CAD file, 2026-11-02]
2027/发球机器人/发球机器人/排球顶球机构/顶球桩总装.SLDASM
固定板（雕刻
GB／T17395-2008普通钢管6×0.3x180 x 4
运动板（雕刻
光轴紧固件（雕刻 x 8
角码20x20x16 x 4
方形卡扣（采购 x 8
顶球桩（打印
