cairuijie-cai/RC-volleyball/2026/R5/气缸车（排球 2）(1)/中间气缸盒式结构.SLDASM

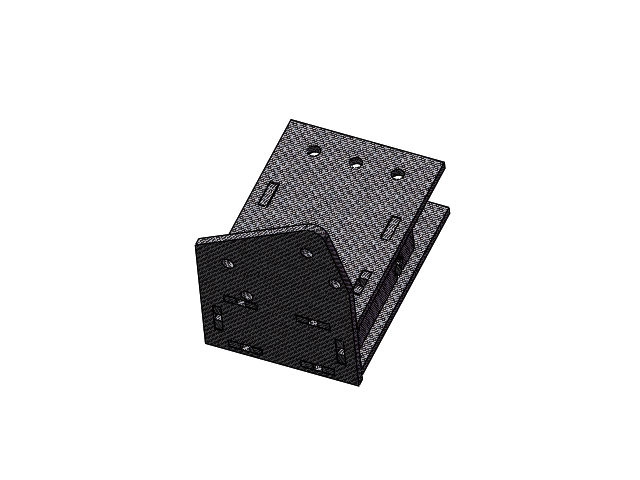
[picture p74: CAD file, 2026-11-02]
2026/R5/气缸车（排球 2）(1)/中间气缸盒式结构.SLDASM
中间气缸盒式结构2 x 2
中间气缸盒型结构1 x 2
中间气缸盒型结构3
