cairuijie-cai/RC-volleyball/2026/R5/气缸车（排球 2）(1)/电池组1.SLDASM

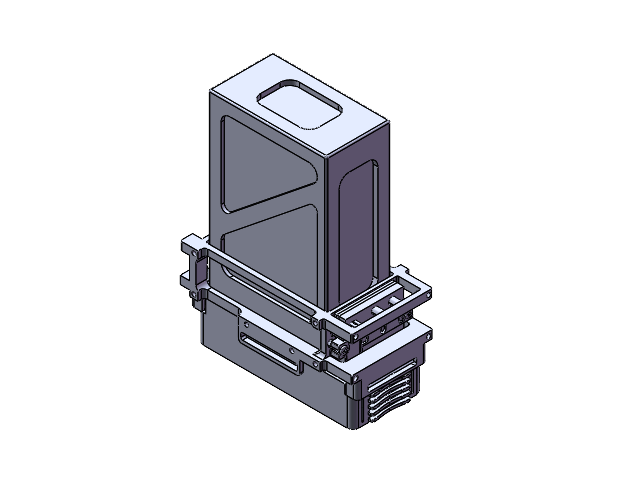
[picture p75: CAD file, 2026-11-02]
2026/R5/气缸车（排球 2）(1)/电池组1.SLDASM
大疆电池座-2017版(1).step
TB47D00_1_1.step
