cairuijie-cai/RC-volleyball/2026/R4/简陋发球车/小简陋.SLDASM

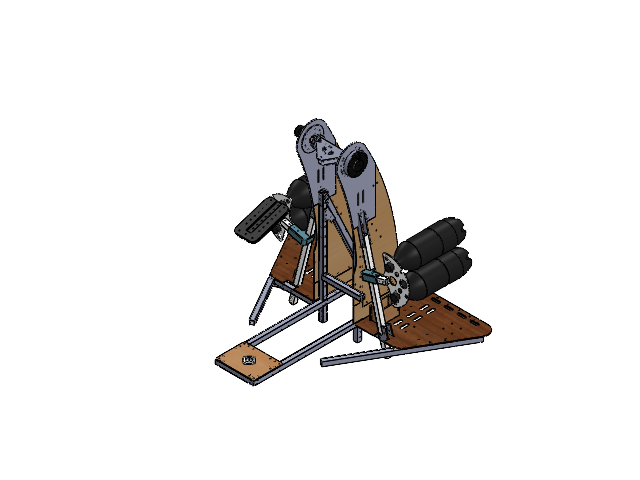
[picture p76: CAD file, 2026-11-02]
2026/R4/简陋发球车/小简陋.SLDASM
后置架
车辕 x 2
斜撑底 x 2
60度拐角
斜撑玻纤 x 3
玻纤
摆臂横撑 x 2
后撑 x 2
XXX x 2
板
吸盘ZUO
竖管520 x 2
新刀币 x 4
XIE x 2
30度拐角 x 2
后洗盘板
后板 x 2
电池1 x 2
电池2 x 2
气瓶铝 x 2
铝管气瓶 x 2
气瓶安装板 x 2
A&T气瓶105 x 4
轴承30 42 7 x 2
玻纤1
打印件1
套环
中环
轴承45 58 7
后盖
后挡板
端盖
打球拍
3508电机.
3508转轴
法兰盘锁紧
3508固定板
3508打印件
转换器
光电门2
滑片
