cairuijie-cai/RC-volleyball/2026/R5/气缸车（排球 2）(1)/排球R2--初始版.SLDASM

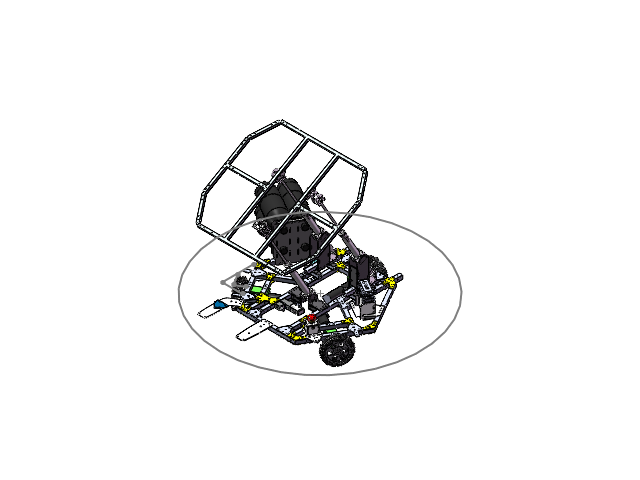
[picture p78: CAD file, 2026-11-02]
2026/R5/气缸车（排球 2）(1)/排球R2--初始版.SLDASM
泡泡-底盘
电池1 x 2
电池2 x 2
电池3
电池4
电池5
大疆电池座-2017版(1).step
TB47D00_1_1.step
4V210-08A电磁阀AC220V[4DV210-08]
泡泡轮组 x 3
A&T气瓶105 x 4
气瓶安装板3
气瓶安装板4 x 4
气瓶安装板5
气瓶安装板6
急停安装板2
急停安装板1 x 2
急停安装板3 x 2
急停开关
急停安装板4
MA迷你气缸系列[MA25×250]_机体 x 3
MA迷你气缸系列[MA25×250]_活塞 x 3
垫高铝管 x 4
垫高铝管2 x 2
垫高铝的连接 x 2
气缸尾部安装侧板 x 4
内8外14 h4推力滚珠轴承 x 4
塞打螺栓-气缸尾部 x 2
气缸尾部垫片-木板 x 4
M6防松螺母 x 2
气缸头连接1 x 4
气缸头连接2 x 3
气缸头连接3 x 3
气缸头连接4 x 3
气缸固定打印件 x 3
气缸固定安装玻纤 x 4
气缸固定垫片-打印件 x 4
中间气缸盒式结构2 x 4
中间气缸盒型结构1 x 4
中间气缸盒型结构3 x 2
M4系列螺栓
M系列螺母
球拍-初代
气缸头连接侧板 x 4
推射支撑打印件 x 2
气缸头连接1-2 x 2
气缸头连接5
激光
rPmj-Board.step
