cairuijie-cai/RC-volleyball/2026/R4/简陋发球车/111.SLDASM

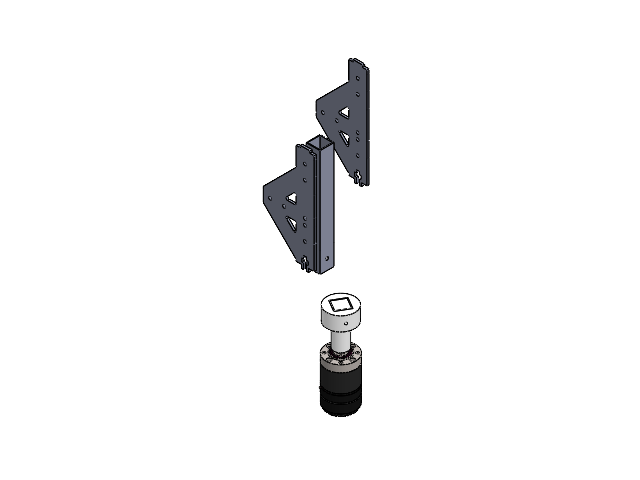
[picture p79: CAD file, 2026-11-02]
2026/R4/简陋发球车/111.SLDASM
3508电机.
3508转轴
电机固定
