cairuijie-cai/RC-volleyball/2026/R5/气缸车（排球 2）(1)/气缸尾部安装-2代.SLDASM

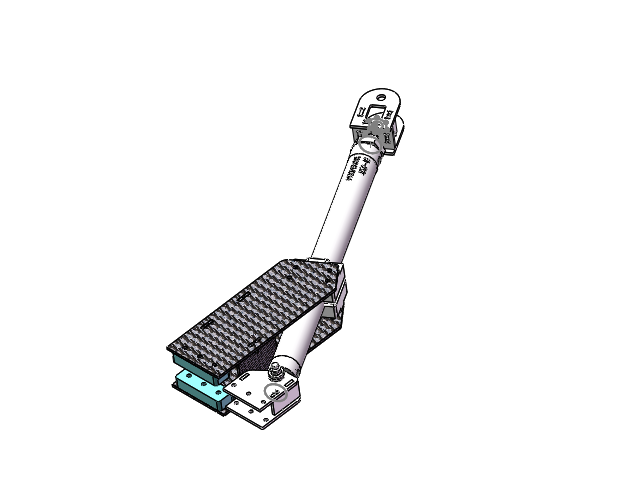
[picture p80: CAD file, 2026-11-02]
2026/R5/气缸车（排球 2）(1)/气缸尾部安装-2代.SLDASM
气缸尾部安装侧板 x 2
气缸尾部安装前板
气缸尾部安装后板
内8外14 h4推力滚珠轴承 x 2
塞打螺栓-气缸尾部
气缸尾部垫片-木板 x 2
M6防松螺母
气缸头连接1 x 2
气缸头连接2
气缸头连接3
气缸头连接4
气缸固定打印件
气缸固定安装玻纤 x 2
气缸支撑板1
气缸支撑板2
气缸固定垫片-打印件 x 2
MA迷你气缸系列[MA25×250]_机体
MA迷你气缸系列[MA25×250]_活塞
