cairuijie-cai/RC-volleyball/2026/R4/简陋发球车/舵轮.SLDASM

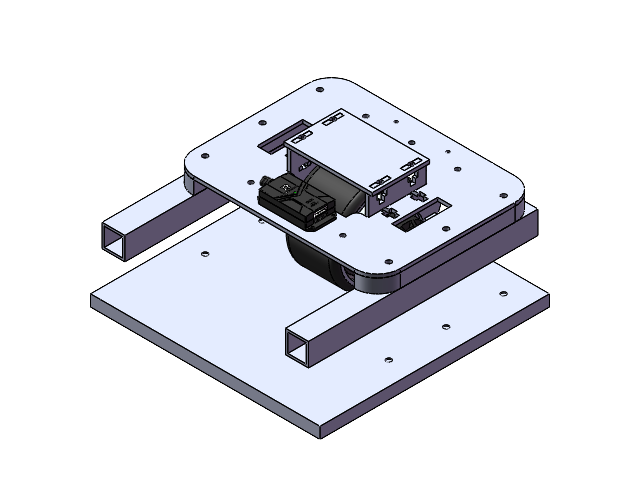
[picture p81: CAD file, 2026-11-02]
2026/R4/简陋发球车/舵轮.SLDASM
DI
5.1轮子80
3508电机5.1套筒2023.4.25
3508减速5.1
3508电机屁股
D型槽大板
舵轮边
ZBA推力滚针轴承[ZBA1024]
内10外15法兰轴承
舵轮边2
C620电调_标件_01
木头增高（可压缩调高度） x 2
50-65-7-深沟球轴承
防尘罩
