cairuijie-cai/RC-volleyball/(list of files, cad)

Other CAD files:
2027/素材/RM论坛排球开源/RC2026-福州大学-浮舟湿地-R2排球机器人机械结构开源/RC2026-福州大学-浮舟湿地-R2排球机器人机械结构开源/三维图纸/三维图纸/R41_Défaut.SLDASM
2027/素材/RM论坛排球开源/RC2026-福州大学-浮舟湿地-R2排球机器人机械结构开源/RC2026-福州大学-浮舟湿地-R2排球机器人机械结构开源/三维图纸/三维图纸/R52_Défaut.SLDASM
2027/素材/RM论坛排球开源/RC2026-福州大学-浮舟湿地-R2排球机器人机械结构开源/RC2026-福州大学-浮舟湿地-R2排球机器人机械结构开源/三维图纸/三维图纸/C8_Défaut.SLDASM
2027/素材/RM论坛排球开源/RC2026-福州大学-浮舟湿地-R2排球机器人机械结构开源/RC2026-福州大学-浮舟湿地-R2排球机器人机械结构开源/三维图纸/三维图纸/R6_Défaut.SLDASM
2027/素材/RM论坛排球开源/RC2026-福州大学-浮舟湿地-R2排球机器人机械结构开源/RC2026-福州大学-浮舟湿地-R2排球机器人机械结构开源/三维图纸/三维图纸/D42_Défaut.SLDASM
2027/素材/RM论坛排球开源/RC2026-福州大学-浮舟湿地-R2排球机器人机械结构开源/RC2026-福州大学-浮舟湿地-R2排球机器人机械结构开源/三维图纸/三维图纸/D36_Défaut.SLDASM
2027/素材/RM论坛排球开源/RC2026-福州大学-浮舟湿地-R2排球机器人机械结构开源/RC2026-福州大学-浮舟湿地-R2排球机器人机械结构开源/三维图纸/三维图纸/D38_Défaut.SLDASM
2027/素材/RM论坛排球开源/RC2026-福州大学-浮舟湿地-R2排球机器人机械结构开源/RC2026-福州大学-浮舟湿地-R2排球机器人机械结构开源/三维图纸/三维图纸/C25_Défaut.SLDASM
2027/素材/RM论坛排球开源/RC2026-福州大学-浮舟湿地-R2排球机器人机械结构开源/RC2026-福州大学-浮舟湿地-R2排球机器人机械结构开源/三维图纸/三维图纸/C47_Défaut.SLDASM
2027/素材/RM论坛排球开源/RC2026-福州大学-浮舟湿地-R2排球机器人机械结构开源/RC2026-福州大学-浮舟湿地-R2排球机器人机械结构开源/三维图纸/三维图纸/D23_Défaut.SLDASM
2027/素材/RM论坛排球开源/RC2026-福州大学-浮舟湿地-R2排球机器人机械结构开源/RC2026-福州大学-浮舟湿地-R2排球机器人机械结构开源/三维图纸/三维图纸/CN9~CONN-TH_XT60PW-M~CONN-TH_XT60PW-M~spCl_1.step.SLDASM
2027/素材/RM论坛排球开源/RC2026-福州大学-浮舟湿地-R2排球机器人机械结构开源/RC2026-福州大学-浮舟湿地-R2排球机器人机械结构开源/三维图纸/三维图纸/R77_Défaut.SLDASM
2027/素材/RM论坛排球开源/RC2026-福州大学-浮舟湿地-R2排球机器人机械结构开源/RC2026-福州大学-浮舟湿地-R2排球机器人机械结构开源/三维图纸/三维图纸/R58_Défaut.SLDASM
2027/素材/RM论坛排球开源/RC2026-福州大学-浮舟湿地-R2排球机器人机械结构开源/RC2026-福州大学-浮舟湿地-R2排球机器人机械结构开源/三维图纸/三维图纸/C9_Défaut.SLDASM
2027/素材/RM论坛排球开源/RC2026-福州大学-浮舟湿地-R2排球机器人机械结构开源/RC2026-福州大学-浮舟湿地-R2排球机器人机械结构开源/三维图纸/三维图纸/KEY-SMD_SKRTLAE010.step_Défaut.SLDASM
2027/素材/RM论坛排球开源/RC2026-福州大学-浮舟湿地-R2排球机器人机械结构开源/RC2026-福州大学-浮舟湿地-R2排球机器人机械结构开源/三维图纸/三维图纸/U7_Défaut.SLDASM
2027/素材/RM论坛排球开源/RC2026-福州大学-浮舟湿地-R2排球机器人机械结构开源/RC2026-福州大学-浮舟湿地-R2排球机器人机械结构开源/三维图纸/三维图纸/P16_Défaut.SLDASM
2027/素材/RM论坛排球开源/RC2026-福州大学-浮舟湿地-R2排球机器人机械结构开源/RC2026-福州大学-浮舟湿地-R2排球机器人机械结构开源/三维图纸/三维图纸/R31_Défaut.SLDASM
2027/素材/RM论坛排球开源/RC2026-福州大学-浮舟湿地-R2排球机器人机械结构开源/RC2026-福州大学-浮舟湿地-R2排球机器人机械结构开源/三维图纸/三维图纸/排球底盘v2.4.SLDASM
2027/素材/RM论坛排球开源/RC2026-福州大学-浮舟湿地-R2排球机器人机械结构开源/RC2026-福州大学-浮舟湿地-R2排球机器人机械结构开源/三维图纸/三维图纸/CN10~CONN-TH_XT30UPB-F~CONN-TH_XT30UPB-F~AsGP.step.SLDASM
2027/素材/RM论坛排球开源/RC2026-福州大学-浮舟湿地-R2排球机器人机械结构开源/RC2026-福州大学-浮舟湿地-R2排球机器人机械结构开源/三维图纸/三维图纸/C48_Défaut.SLDASM
2026/R5/气缸车（排球 2）(1)/缓震轮组.SLDASM
2027/素材/RM论坛排球开源/RC2026-福州大学-浮舟湿地-R2排球机器人机械结构开源/RC2026-福州大学-浮舟湿地-R2排球机器人机械结构开源/三维图纸/三维图纸/P7_Défaut.SLDASM
2027/素材/RM论坛排球开源/RC2026-福州大学-浮舟湿地-R2排球机器人机械结构开源/RC2026-福州大学-浮舟湿地-R2排球机器人机械结构开源/三维图纸/三维图纸/DQJ0008A_Défaut.SLDASM
2027/素材/RM论坛排球开源/RC2026-福州大学-浮舟湿地-R2排球机器人机械结构开源/RC2026-福州大学-浮舟湿地-R2排球机器人机械结构开源/三维图纸/三维图纸/D15_Défaut.SLDASM
2027/素材/RM论坛排球开源/RC2026-福州大学-浮舟湿地-R2排球机器人机械结构开源/RC2026-福州大学-浮舟湿地-R2排球机器人机械结构开源/三维图纸/三维图纸/R2_Défaut.SLDASM
2027/素材/RM论坛排球开源/RC2026-福州大学-浮舟湿地-R2排球机器人机械结构开源/RC2026-福州大学-浮舟湿地-R2排球机器人机械结构开源/三维图纸/三维图纸/R10_Défaut.SLDASM
2027/素材/RM论坛排球开源/RC2026-福州大学-浮舟湿地-R2排球机器人机械结构开源/RC2026-福州大学-浮舟湿地-R2排球机器人机械结构开源/三维图纸/三维图纸/Board_Défaut.SLDASM
2027/素材/RM论坛排球开源/RC2026-福州大学-浮舟湿地-R2排球机器人机械结构开源/RC2026-福州大学-浮舟湿地-R2排球机器人机械结构开源/三维图纸/三维图纸/C11_Défaut.SLDASM
2027/素材/RM论坛排球开源/RC2026-福州大学-浮舟湿地-R2排球机器人机械结构开源/RC2026-福州大学-浮舟湿地-R2排球机器人机械结构开源/三维图纸/三维图纸/R94_Défaut.SLDASM
2026/R4/简陋发球车/装配体1.SLDASM
2027/素材/RM论坛排球开源/RC2026-福州大学-浮舟湿地-R2排球机器人机械结构开源/RC2026-福州大学-浮舟湿地-R2排球机器人机械结构开源/三维图纸/三维图纸/CN3~CONN-TH_XT30UPB-F~CONN-TH_XT30UPB-F~EVRb.step.SLDASM
2027/素材/RM论坛排球开源/RC2026-福州大学-浮舟湿地-R2排球机器人机械结构开源/RC2026-福州大学-浮舟湿地-R2排球机器人机械结构开源/三维图纸/三维图纸/C62_Défaut.SLDASM
2027/素材/RM论坛排球开源/RC2026-福州大学-浮舟湿地-R2排球机器人机械结构开源/RC2026-福州大学-浮舟湿地-R2排球机器人机械结构开源/三维图纸/三维图纸/R57_Défaut.SLDASM
2027/素材/RM论坛排球开源/RC2026-福州大学-浮舟湿地-R2排球机器人机械结构开源/RC2026-福州大学-浮舟湿地-R2排球机器人机械结构开源/三维图纸/三维图纸/R75_Défaut.SLDASM
2027/素材/RM论坛排球开源/RC2026-福州大学-浮舟湿地-R2排球机器人机械结构开源/RC2026-福州大学-浮舟湿地-R2排球机器人机械结构开源/三维图纸/三维图纸/U5_Défaut.SLDASM
2027/素材/RM论坛排球开源/RC2026-福州大学-浮舟湿地-R2排球机器人机械结构开源/RC2026-福州大学-浮舟湿地-R2排球机器人机械结构开源/三维图纸/三维图纸/R56_Défaut.SLDASM
2027/素材/RM论坛排球开源/RC2026-福州大学-浮舟湿地-R2排球机器人机械结构开源/RC2026-福州大学-浮舟湿地-R2排球机器人机械结构开源/三维图纸/三维图纸/CN3~CONN-TH_2P-P1.25_XUNPU_WAFER-GH1.25-2PWB~CONN-TH_2P-P1.25_XUNPU_WAFER-GH1.25-2PWB~CM91_1.step.SLDASM
2027/素材/RM论坛排球开源/RC2026-福州大学-浮舟湿地-R2排球机器人机械结构开源/RC2026-福州大学-浮舟湿地-R2排球机器人机械结构开源/三维图纸/三维图纸/R11_Défaut.SLDASM
2027/素材/RM论坛排球开源/RC2026-福州大学-浮舟湿地-R2排球机器人机械结构开源/RC2026-福州大学-浮舟湿地-R2排球机器人机械结构开源/三维图纸/三维图纸/R46_Défaut.SLDASM
2027/素材/RM论坛排球开源/RC2026-福州大学-浮舟湿地-R2排球机器人机械结构开源/RC2026-福州大学-浮舟湿地-R2排球机器人机械结构开源/三维图纸/三维图纸/U18_Défaut.SLDASM
2027/素材/RM论坛排球开源/RC2026-福州大学-浮舟湿地-R2排球机器人机械结构开源/RC2026-福州大学-浮舟湿地-R2排球机器人机械结构开源/三维图纸/三维图纸/CtrBoard-H7_V1.0-240112A_Défaut.SLDASM
2027/素材/RM论坛排球开源/RC2026-福州大学-浮舟湿地-R2排球机器人机械结构开源/RC2026-福州大学-浮舟湿地-R2排球机器人机械结构开源/三维图纸/三维图纸/C60_Défaut.SLDASM
2027/素材/RM论坛排球开源/RC2026-福州大学-浮舟湿地-R2排球机器人机械结构开源/RC2026-福州大学-浮舟湿地-R2排球机器人机械结构开源/三维图纸/三维图纸/排球R2.SLDASM
2027/素材/RM论坛排球开源/RC2026-福州大学-浮舟湿地-R2排球机器人机械结构开源/RC2026-福州大学-浮舟湿地-R2排球机器人机械结构开源/三维图纸/三维图纸/R39_Défaut.SLDASM
2027/素材/RM论坛排球开源/RC2026-福州大学-浮舟湿地-R2排球机器人机械结构开源/RC2026-福州大学-浮舟湿地-R2排球机器人机械结构开源/三维图纸/三维图纸/C73_Défaut.SLDASM
2027/素材/RM论坛排球开源/RC2026-福州大学-浮舟湿地-R2排球机器人机械结构开源/RC2026-福州大学-浮舟湿地-R2排球机器人机械结构开源/三维图纸/三维图纸/R28_Défaut.SLDASM
2027/素材/RM论坛排球开源/RC2026-福州大学-浮舟湿地-R2排球机器人机械结构开源/RC2026-福州大学-浮舟湿地-R2排球机器人机械结构开源/三维图纸/三维图纸/F10_Défaut.SLDASM
2027/素材/RM论坛排球开源/RC2026-福州大学-浮舟湿地-R2排球机器人机械结构开源/RC2026-福州大学-浮舟湿地-R2排球机器人机械结构开源/三维图纸/三维图纸/Q2_Défaut.SLDASM
2027/素材/RM论坛排球开源/RC2026-福州大学-浮舟湿地-R2排球机器人机械结构开源/RC2026-福州大学-浮舟湿地-R2排球机器人机械结构开源/三维图纸/三维图纸/D3_Défaut.SLDASM
2027/素材/RM论坛排球开源/RC2026-福州大学-浮舟湿地-R2排球机器人机械结构开源/RC2026-福州大学-浮舟湿地-R2排球机器人机械结构开源/三维图纸/三维图纸/R88_Défaut.SLDASM
2027/素材/RM论坛排球开源/RC2026-福州大学-浮舟湿地-R2排球机器人机械结构开源/RC2026-福州大学-浮舟湿地-R2排球机器人机械结构开源/三维图纸/三维图纸/D40_Défaut.SLDASM
2027/素材/RM论坛排球开源/RC2026-福州大学-浮舟湿地-R2排球机器人机械结构开源/RC2026-福州大学-浮舟湿地-R2排球机器人机械结构开源/三维图纸/三维图纸/D20_Défaut.SLDASM
2027/素材/RM论坛排球开源/RC2026-福州大学-浮舟湿地-R2排球机器人机械结构开源/RC2026-福州大学-浮舟湿地-R2排球机器人机械结构开源/三维图纸/三维图纸/R7_Défaut.SLDASM
2027/素材/RM论坛排球开源/RC2026-福州大学-浮舟湿地-R2排球机器人机械结构开源/RC2026-福州大学-浮舟湿地-R2排球机器人机械结构开源/三维图纸/三维图纸/U1~CONN-SMD_4P-P1.25_GH1.25-4P~CONN-SMD_4P-P1.25_GH1.25-4P~aoOK.step.SLDASM
2027/素材/RM论坛排球开源/RC2026-福州大学-浮舟湿地-R2排球机器人机械结构开源/RC2026-福州大学-浮舟湿地-R2排球机器人机械结构开源/三维图纸/三维图纸/User Library-LED_0603_R_Défaut.SLDASM
2027/素材/RM论坛排球开源/RC2026-福州大学-浮舟湿地-R2排球机器人机械结构开源/RC2026-福州大学-浮舟湿地-R2排球机器人机械结构开源/三维图纸/三维图纸/R8_Défaut.SLDASM
2027/素材/RM论坛排球开源/RC2026-福州大学-浮舟湿地-R2排球机器人机械结构开源/RC2026-福州大学-浮舟湿地-R2排球机器人机械结构开源/三维图纸/三维图纸/C59_Défaut.SLDASM
2027/素材/RM论坛排球开源/RC2026-福州大学-浮舟湿地-R2排球机器人机械结构开源/RC2026-福州大学-浮舟湿地-R2排球机器人机械结构开源/三维图纸/三维图纸/C19_Défaut.SLDASM
2027/素材/RM论坛排球开源/RC2026-福州大学-浮舟湿地-R2排球机器人机械结构开源/RC2026-福州大学-浮舟湿地-R2排球机器人机械结构开源/三维图纸/三维图纸/C35_Défaut.SLDASM
2027/素材/RM论坛排球开源/RC2026-福州大学-浮舟湿地-R2排球机器人机械结构开源/RC2026-福州大学-浮舟湿地-R2排球机器人机械结构开源/三维图纸/三维图纸/111上板.SLDASM
2027/素材/RM论坛排球开源/RC2026-福州大学-浮舟湿地-R2排球机器人机械结构开源/RC2026-福州大学-浮舟湿地-R2排球机器人机械结构开源/三维图纸/三维图纸/HDR-TH_4P-P2.54-V-M.step.STEP.STEP_Défaut.SLDASM
2027/素材/RM论坛排球开源/RC2026-福州大学-浮舟湿地-R2排球机器人机械结构开源/RC2026-福州大学-浮舟湿地-R2排球机器人机械结构开源/三维图纸/三维图纸/L6_Défaut.SLDASM
2027/素材/RM论坛排球开源/RC2026-福州大学-浮舟湿地-R2排球机器人机械结构开源/RC2026-福州大学-浮舟湿地-R2排球机器人机械结构开源/三维图纸/三维图纸/R34_Défaut.SLDASM
2027/素材/RM论坛排球开源/RC2026-福州大学-浮舟湿地-R2排球机器人机械结构开源/RC2026-福州大学-浮舟湿地-R2排球机器人机械结构开源/三维图纸/三维图纸/R5_Défaut.SLDASM
2027/素材/RM论坛排球开源/RC2026-福州大学-浮舟湿地-R2排球机器人机械结构开源/RC2026-福州大学-浮舟湿地-R2排球机器人机械结构开源/三维图纸/三维图纸/BM04B-GHS_Défaut.SLDASM
2027/素材/RM论坛排球开源/RC2026-福州大学-浮舟湿地-R2排球机器人机械结构开源/RC2026-福州大学-浮舟湿地-R2排球机器人机械结构开源/三维图纸/三维图纸/C12_Défaut.SLDASM
2027/素材/RM论坛排球开源/RC2026-福州大学-浮舟湿地-R2排球机器人机械结构开源/RC2026-福州大学-浮舟湿地-R2排球机器人机械结构开源/三维图纸/三维图纸/D2_Défaut.SLDASM
2027/素材/RM论坛排球开源/RC2026-福州大学-浮舟湿地-R2排球机器人机械结构开源/RC2026-福州大学-浮舟湿地-R2排球机器人机械结构开源/三维图纸/三维图纸/P12_Défaut.SLDASM
2027/素材/RM论坛排球开源/RC2026-福州大学-浮舟湿地-R2排球机器人机械结构开源/RC2026-福州大学-浮舟湿地-R2排球机器人机械结构开源/三维图纸/三维图纸/CN6~CONN-SMD_2P-P1.25_X1251WRS-02HF-LPSW~CONN-SMD_GH1.25-WS-2P~lbK5.step.SLDASM
2027/素材/RM论坛排球开源/RC2026-福州大学-浮舟湿地-R2排球机器人机械结构开源/RC2026-福州大学-浮舟湿地-R2排球机器人机械结构开源/三维图纸/三维图纸/D1_Défaut.SLDASM
2027/素材/RM论坛排球开源/RC2026-福州大学-浮舟湿地-R2排球机器人机械结构开源/RC2026-福州大学-浮舟湿地-R2排球机器人机械结构开源/三维图纸/三维图纸/U4_Défaut.SLDASM
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
