cairuijie-cai/RC-volleyball/2027/素材/31x31x19角码参考工程图/31x31x19角码_尺寸参考图_待实测.pdf

# 31×31×19 L 形角码 / 尺寸参考图

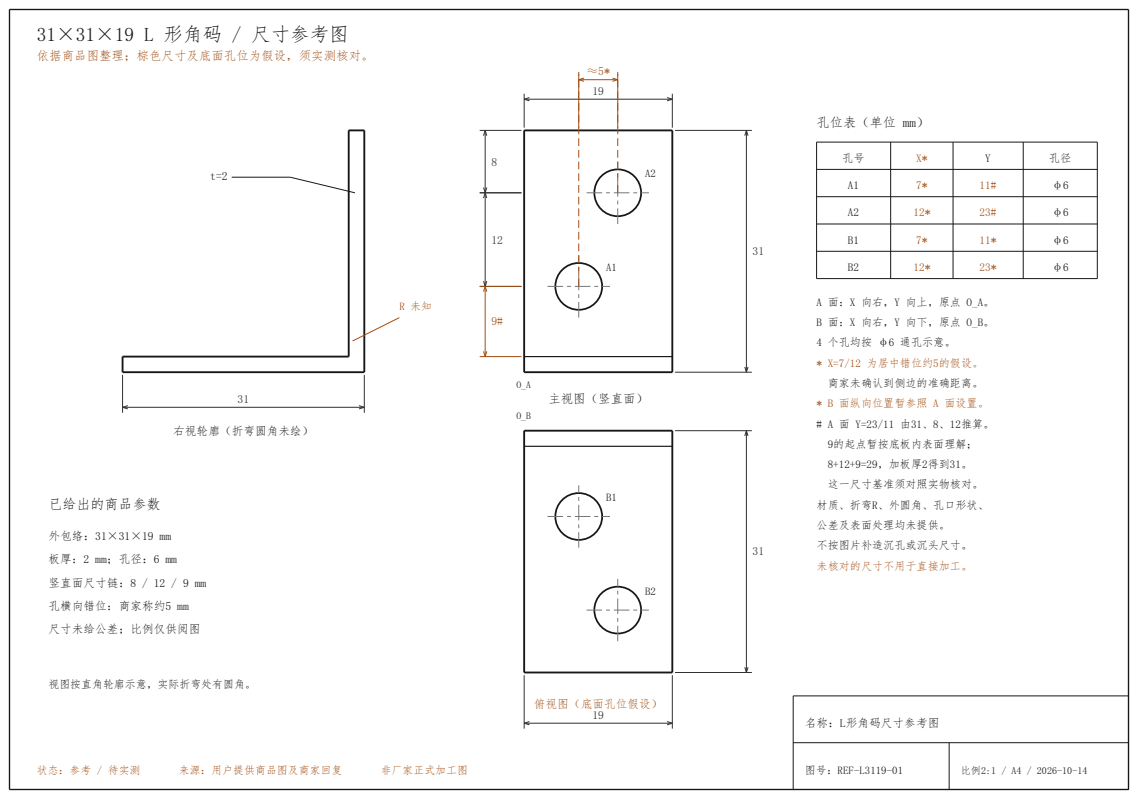
[picture p82: page 1]
主视图（竖直面）; 右视轮廓（折弯圆角未绘）; 俯视图（底面孔位假设）; 4 个孔均按 φ6 通孔示意。; * X=7/12 为居中错位约5的假设。; 商家未确认到侧边的准确距离。; * B 面纵向位置暂参照 A 面设置。; 9的起点暂按底板内表面理解；; 8+12+9=29，加板厚2得到31。; 这一尺寸基准须对照实物核对。; 材质、折弯R、外圆角、孔口形状、; 公差及表面处理均未提供。; 不按图片补造沉孔或沉头尺寸。; 未核对的尺寸不用于直接加工。; 已给出的商品参数; 外包络：31×31×19 mm; 竖直面尺寸链：8 / 12 / 9 mm; 孔横向错位：商家称约5 mm; 尺寸未给公差；比例仅供阅图; 视图按直角轮廓示意，实际折弯处有圆角。; 名称：L形角码尺寸参考图; 状态：参考 / 待实测; 来源：用户提供商品图及商家回复; 非厂家正式加工图; 图号：REF-L3119-01

依据商品图整理；棕色尺寸及底面孔位为假设，须实测核对。

孔位表（单位 mm）
