cairuijie-cai/RC-volleyball/(commit log)

2026-11-02 Add volleyball robot models, BOMs, reference materials and project guide
    [0201_C_Défaut.SLDPRT, 0201_R_Défaut.SLDPRT, 0603_C_Défaut.SLDPRT, 0603_R_Défaut.SLDPRT, 1 8个.SLDPRT, 111.SLDASM, 111DM8006驱动部分.SLDASM, 111上板.SLDASM]
2026-11-03 Remove mechanical training platform and assessment materials
2026-11-03 Add official GO-M8010-6 models, manuals and developer resources
    [GO-M8010-6电机3D模型.stp]
